septiandch/imumonitor/documents/kontrakkerja_201107.md

# KONTRAK KERJA PENGERJAAN ALAT “INERTIAL MEASUREMENT UNIT (IMU)” UNTUK PENILAIAN ERGONOMI

---
[TOC]
---

## 1.TUJUAN DAN RUANG LINGKUP PEKERJAAN

Alat “Inertial Measurement Unit (IMU)” yang akan dibuat, bertujuan untuk memonitor postur tubuh pekerja atau operator untuk penilaian ergonomi secara real-time yang dapat diaplikasikan di perindustrian.

Terdiri dari 7 buah sensor yang diletakkan di bagian tubuh yang telah ditentukan. Sehingga ppenilaian ergonomi dapat dilakukan dengan mendeteksi sudut tiap bagian tubuh. Jika postur tubuh dianggap membahayakan kesehatan, maka akan ada notifikasi alarm yang akan berbunyi. 

Nilai sudut tiap sensor tersebut juga disimpan ke dalam log dan dapat diupload ke dalam database online dengan menggunakan aplikasi smartphone.

## 2.DESAIN KONSEP

### 2.1 Konsep Sistem
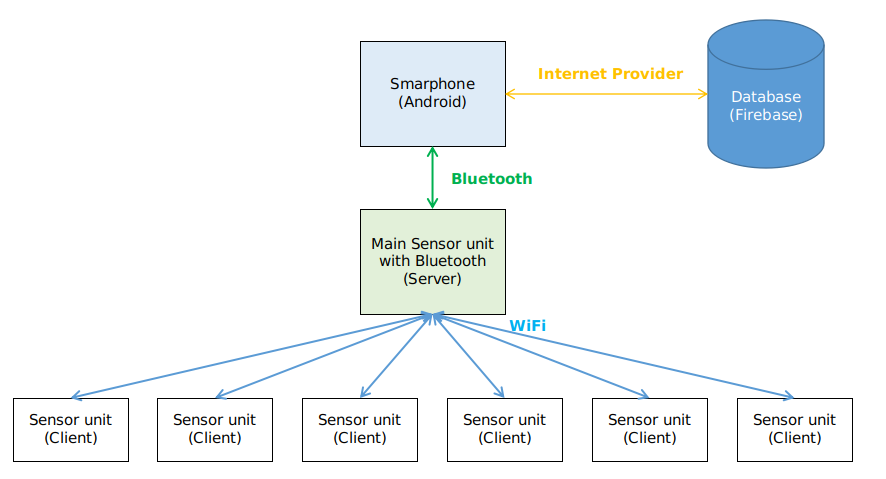
[picture p1: documents/assets/concept.png]
concept


### 2.2 Konsep Alat
Terdiri dari 7 unit modul sensor dengan konfigurasi tiap unit sebagai berikut :				

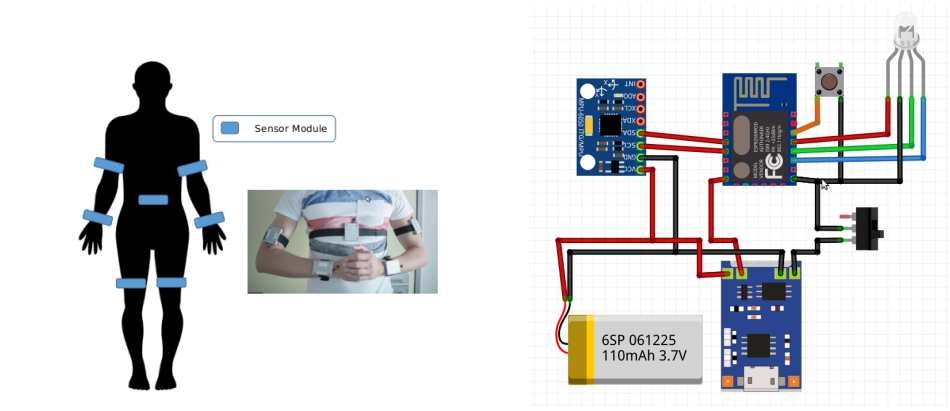
[picture p2: documents/assets/design_idea.png]
design_idea


## 3.ESTIMASI WAKTU PENGERJAAN

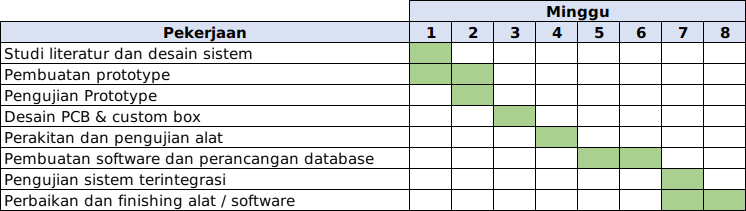
[picture p3: documents/assets/schedule_plan.png]
schedule_plan


*) Pekerjaan dimulai terhitung setelah pembayaran tahap pertama (point [5])

## 4. BATASAN PEKERJAAN

### 4.1 Batasan sistem
Sistem alat yang dikerjakan hanya akan mencakup sesuai dengan desain konsep yang telah dibuat di poin [2]. Jika ada fiitur tambahan atau revisi dapat merujuk ke poin [4.2].

Software yang akan dibuat berupa aplikasi sederhana untuk smartphone android (tidak tersedia untuk Iphone). Dimana aplikasi berfungsi hanya untuk input data pekerja/operator (nama, umur, berat badan, dsb), menerima data log sensor, dan upload data log sensor ke database.

### 4.2 Revisi
Maksimal pengajuan revisi minor adalah sampai sebelum tahap Perbaikan dan finishing alat / software (Minggu ke-6). Untuk revisi major seperti perubahan sistem yang mempengaruhi estimasi waktu pengerjaan, maka perlu di diskusikan lebih lanjut dan akan diperlakukan sebagai pekerjaan terpisah dengan fee dan estimasi tersendiri.

## 5. PEMBAYARAN
Total biaya pembuatan alat “Inertial Measurement Unit (IMU)” adalah sebesar :
Rp. 6.420.000,- dengan detail sebagai berikut :

| Item | Jumlah | Harga/Unit | Harga Total |
| --- | --- | --- | --- |
| Module WiFi + Bluetooth | 1 | 180.000 | 180.000 |
| Module WiFi | 6 | 45.000 | 270.000 |
| Sensor MPU6050 | 7 | 20.000 | 140.000 |
| Alarm Unit | 1 | 5.000 | 5.000 |
| Baterai LiPo | 7 | 150.000 | 1.050.000 |
| Printed Circuit Board (PCB) | 7 | 25.000 | 175.000 |
| Custom 3D Printed Box | 8 | 75.000 | 600.000 |
| Jasa Pembuatan Aplikasi Android | 1 | - | - |
| Jasa Pengerjaan Alat | 1 | 4.000.000  | 4.000.000 |
| TOTAL BIAYA | | | **6.420.000** |

Pembayaran dilakukan secara bertahap dengan ketentuan sebagai berikut:

1. Pembayaran pertama sebesar 25% (dua puluh lima persen) dari nilai total biaya, sejumlah Rp 1.605.000,-. Dibayarkan pada saat kontrak kerja disetujui.

2. Pembayaran kedua sebesar 25% (dua puluh lima persen) dari nilai total biaya, sejumlah Rp 1.605.000,-. Dibayarkan pada saat Perakitan dan Pengujian alat selesai. Di tahap ini, pengerjaan alat sudah mencapai 50% (jika sesuai estimasi, di minggu ke-5).

3. Pembayaran ketiga sebesar 50% (lima puluh persen) dari nilai total biaya, sejumlah Rp 3.210.000,-. Dibayarkan setelah pekerjaan telah selesai. Di tahap ini, alat (hardware + software) akan diserahkan kepada Client.

Pembayaran oleh pihak Client dapat dilakukan dengan cara transfer ke : 

> Bank BCA a/n	: *SEPTIAN DWI CHANDRA*
> No. Rekening	: *7880740398*

**) Mohon melakukan konfirmasi setelah pembayaran*
