septiandch/imumonitor/documents/assets/OWAS_Judgement_Concept.xlsx

Back
OWAS | Condition | Flexion (Roll) | Lateral (Pitch) | Axial (Yaw) | Remark | Input
1 | straight | 0 ~ | x | 0 ~ | Only use Roll & Yaw | Bent Range 0>
2 | bent | ±20 ~ | x | 0 ~
3 | Twisted | 0 ~ | x | ±20 ~ |  | Twisted Range 0>
4 | Bent & Twisted | ±20 ~ | x | ±20 ~
Arms
OWAS | Condition | Upper Arm 1 | Upper Arm 2 | Remark | Input
1 | Below Both arms below shoulder level | 0 ~ | 0 ~ | Only use Roll & Pitch | Shoulder Level range <90>
2 | One arm at or above shoulder level | +90 > | 0 ~
3 | Two arms at or above shoulder level | +90 > | -90 >
Legs
OWAS | Condition | Upper Leg 1 | Lower Leg 1 | Upper Leg 2 | Lower Leg 2 | Remark | Input
1 | Sit | +90 ~ | x | -90 ~ | x | Only use Roll | Sit | Upper Leg <90>
2 | Standing two legs straight | 0 ~ | 0 ~ | 0 ~ | 0 ~ |  | Standing | Upper Leg <0>
3 | Standing one leg straight | 0 ~ | 0 ~ | ±20 ~ | x |  | Standing | Lower Leg <0>
4 | Squatting two legs bent | +20 ~ | +20 ~ | -20 ~ | -20 ~ |  | Squatting | Upper leg <120>
5 | Squatting one leg bent | +20 ~ | +20 ~ | -45 ~ | x |  | Kneeling | Lower legs <90>
6 | Kneeling | +45 ~ | +90 ~ | +45 ~ | -90 ~ |  | Walking | upper Leg <20>
7 | Walking | +45 ~ | x | +45 ~ | x
