septiandch/imumonitor/program/mobileapp/assets/img/save.png

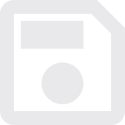
program/mobileapp/assets/img/save.png
