septiandch/imumonitor/hardware/enclosure/enclosure_cover.FCStd

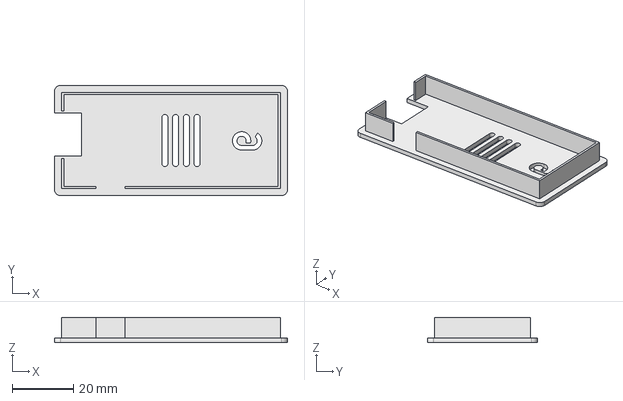
[picture p6: CAD file, 2021-11-16]
hardware/enclosure/enclosure_cover.FCStd
76.0 x 36.0 x 8.25 mm
