septiandch/imumonitor/hardware/enclosure/enclosure_holder_alarm.FCStd

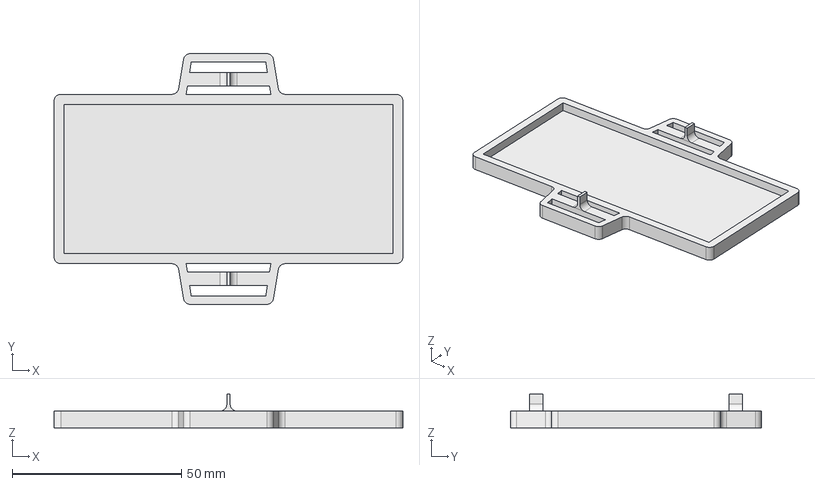
[picture p7: CAD file, 2021-11-16]
hardware/enclosure/enclosure_holder_alarm.FCStd
103.0 x 74.0 x 10.0 mm
