septiandch/imumonitor/hardware/enclosure/enclosure_server.FCStd

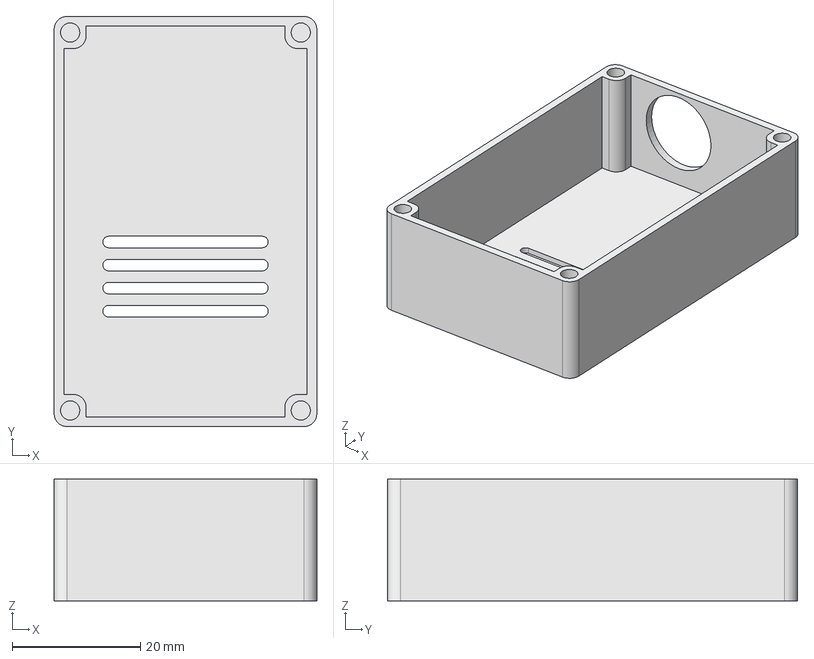
[picture p8: CAD file, 2021-04-25]
hardware/enclosure/enclosure_server.FCStd
41.0 x 64.0 x 19.0 mm
