septiandch/imumonitor/hardware/enclosure/enclosure_container.FCStd

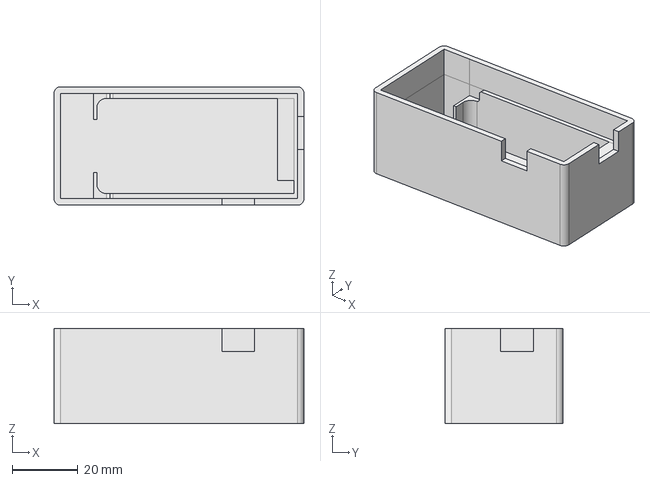
[picture p9: CAD file, 2021-03-23]
hardware/enclosure/enclosure_container.FCStd
76.0 x 36.0 x 29.0 mm
