septiandch/imumonitor/hardware/enclosure/enclosure_holder.FCStd

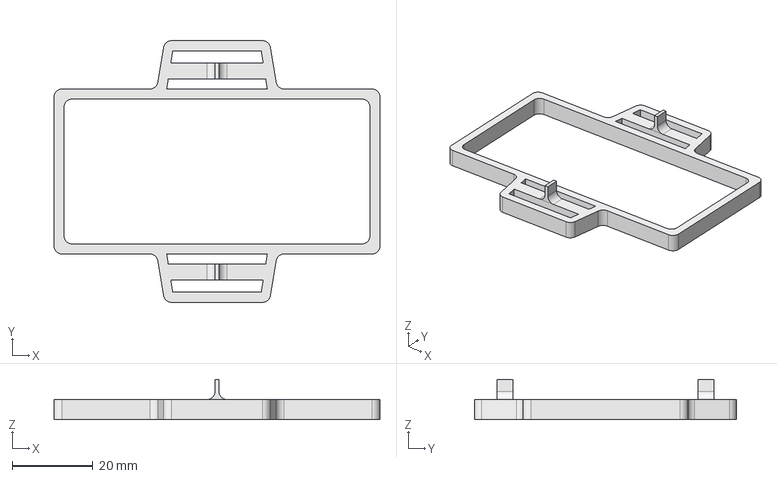
[picture p10: CAD file, 2021-03-23]
hardware/enclosure/enclosure_holder.FCStd
81.0 x 65.0 x 10.0 mm
