septiandch/imumonitor/hardware/schematics/imunodes/Output/imunodes-brd.pdf

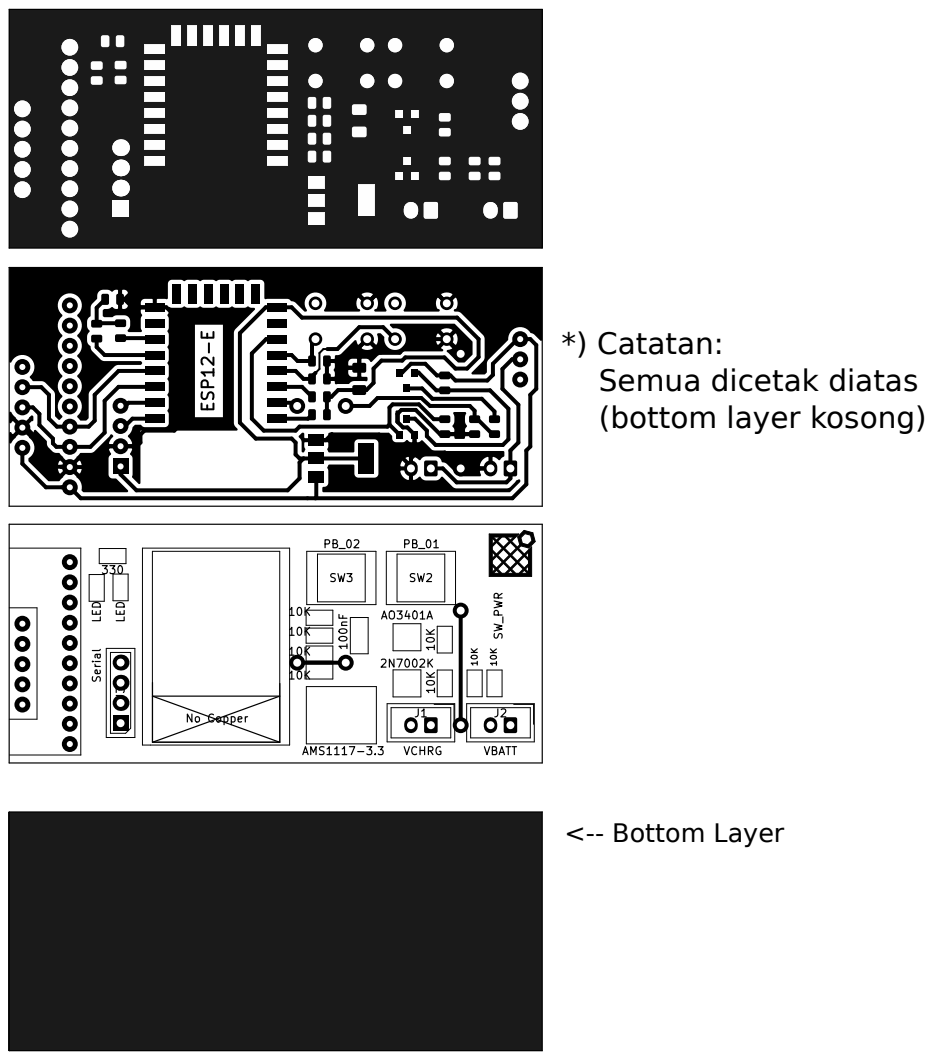
[picture p11: page 1]
<-- Bottom Layer

*) Catatan:
Semua dicetak diatas
(bottom layer kosong)
