septiandch/imumonitor/hardware/schematics/imunodes/imunodes.kicad_pcb

## KiCad design hardware/schematics/imunodes/imunodes.kicad_pcb (2021-01-02)

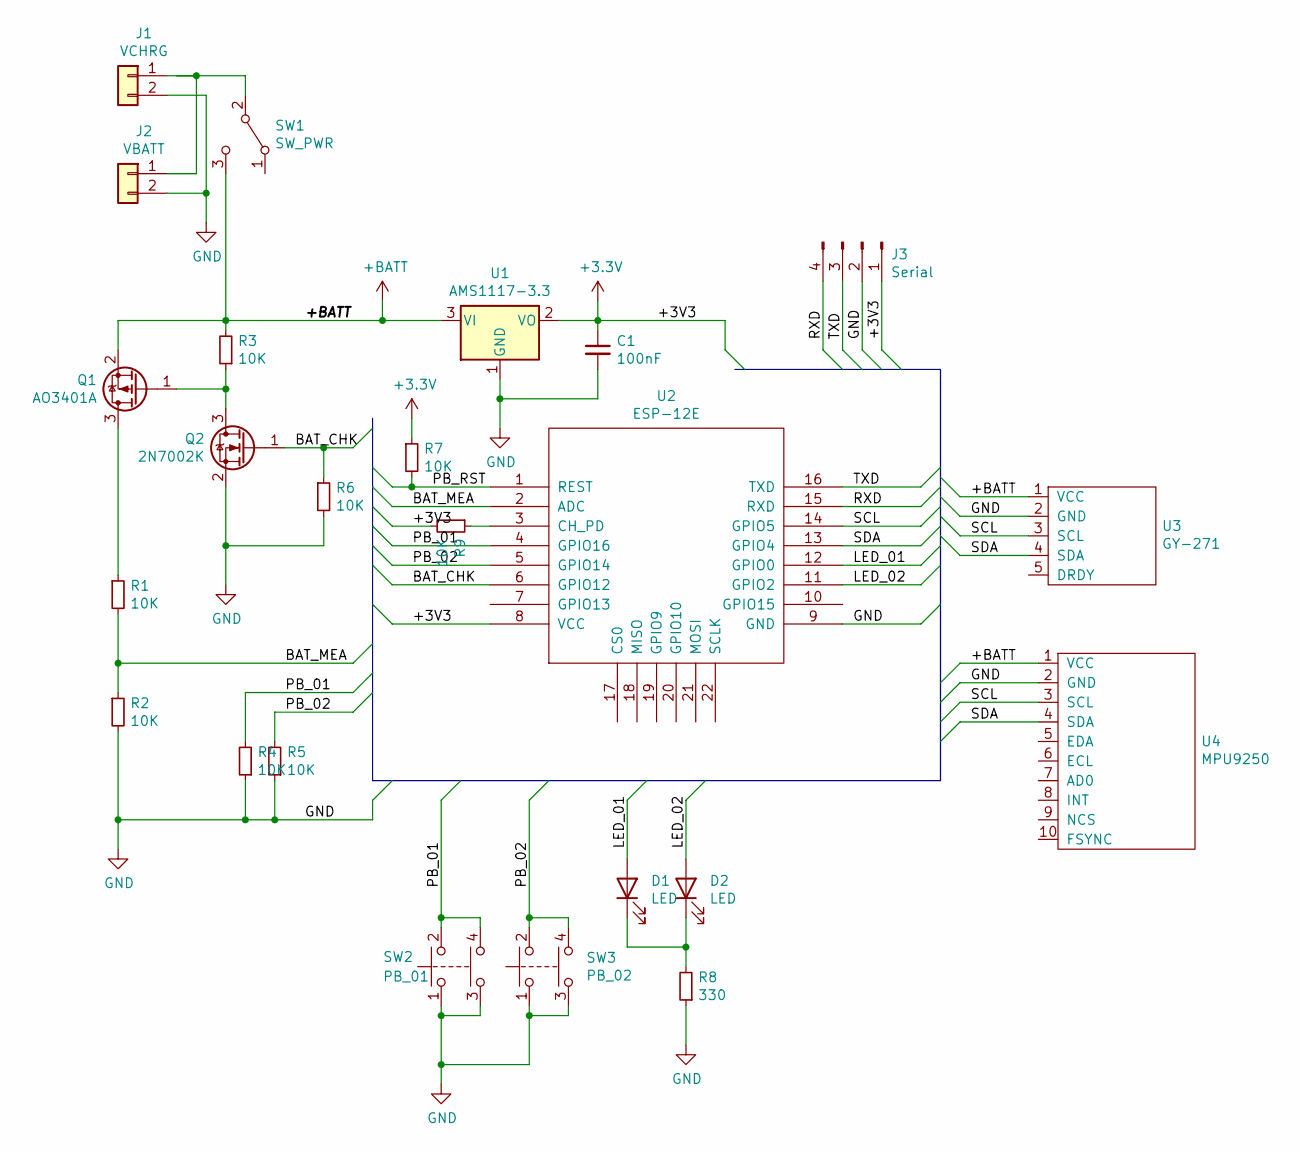
[picture p12: schematic imunodes.sch]

Parts:
C1: 100nF; C_1206_3216Metric
D1, D2: LED; LED_0805_2012Metric
J1: VCHRG; JST_EH_B2B-EH-A_1x02_P2.50mm_Vertical
J2: VBATT; JST_EH_B2B-EH-A_1x02_P2.50mm_Vertical
J3: Serial; PinHeader_1x04_P2.54mm_Vertical
Q1: AO3401A; SOT-23
Q2: 2N7002K; SOT-23
R1, R2, R3, R4, R5, R6, R7, R9: 10K; R_0805_2012Metric
R8: 330; R_0805_2012Metric
SW1: SW_PWR; SlideSwitch_SS12D00_1P2T_H3mm
SW2: PB_01; SW_TH_Tactile_Omron_B3F-10xx
SW3: PB_02; SW_TH_Tactile_Omron_B3F-10xx
U1: AMS1117-3.3; SOT-223-3_TabPin2
U2: ESP-12E; ESP-12E_SMD
U3: GY-271; GY271
U4: MPU9250

Connections:
+3V3: C1.1, J3.1, R7.1, R9.2, U1.2 (VO), U2.8 (VCC)
+BATT: Q1.2 (S), R3.2, SW1.3 (C), U1.3 (VI), U3.1 (VCC), U4.1 (VCC)
/BAT_CHK: Q2.1 (G), R6.1, U2.6 (GPIO12)
/BAT_MEA: R1.2, R2.1, U2.2 (ADC)
/LED_01: D1.2 (A), U2.12 (GPIO0)
/LED_02: D2.2 (A), U2.11 (GPIO2)
/PB_01: R4.2, SW2.2, SW2.4, U2.4 (GPIO16)
/PB_02: R5.2, SW3.2, SW3.4, U2.5 (GPIO14)
/PB_RST: R7.2, U2.1 (REST)
/RXD: J3.4, U2.15 (RXD)
/SCL: U2.14 (GPIO5), U3.3 (SCL), U4.3 (SCL)
/SDA: U2.13 (GPIO4), U3.4 (SDA), U4.4 (SDA)
/TXD: J3.3, U2.16 (TXD)
GND: C1.2, J1.2, J2.2, J3.2, Q2.2 (S), R2.2, R4.1, R5.1, R6.2, R8.1, SW2.1, SW2.3, SW3.1, SW3.3, U1.1 (GND), U2.9 (GND), U3.2 (GND), U4.2 (GND)
unnamed: D1.1 (K), D2.1 (K), R8.2
unnamed: J1.1, J2.1, SW1.2 (B)
unnamed: Q1.1 (G), Q2.3 (D), R3.1
unnamed: Q1.3 (D), R1.1
unnamed: R9.1, U2.3 (CH_PD)

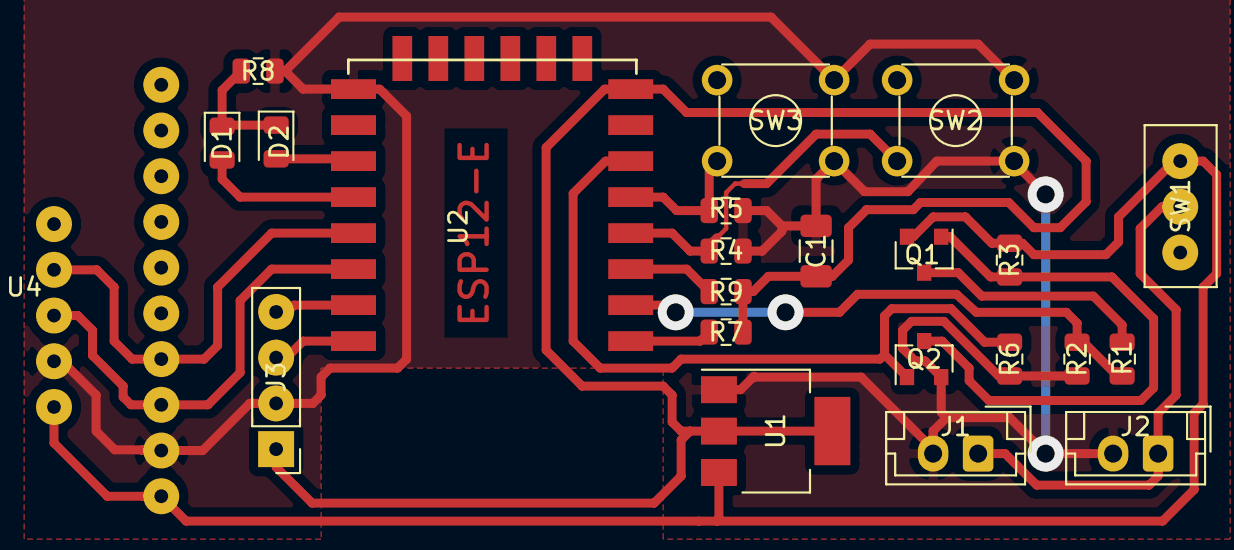
[picture p13: board imunodes.kicad_pcb from above]

Board: 2 copper layers, 24 parts (0 on the bottom side), 19 nets.
