septiandch/imumonitor/(commit log)

2021-01-02 20210102_First Commit
    [imunodes.kicad_pcb, imunodes.sch]
2021-01-24 **[ New ]** - Sensor Monitor view - Bottom Sheet view
    **[ Fixes ]**
    - Received Value conversion bug fix
    - Linechart view improvement
    - Dummy registration fix
    - Sensor Monitor initial dummy value fix
2021-01-27 [New] - Shared Prefferences - Horizontal Number Picker for setting values - User Data Updates - OWAS data base
    [Fixed]
    - Received values conversion fix
    - BLE Device Screen return without selected device bug fix
2021-03-23 Add Freecad Enclosure Drawing
    [enclosure_container.FCStd, enclosure_cover.FCStd, enclosure_holder.FCStd]
2021-04-14 New Structure: Separate as ImuNodes and ImuServer
    [OWAS_Judgement_Concept.xlsx]
2021-04-25 ImuNodes & ImuServer Fixes
    GET request improvement so no node data can be retrieved sequentially
    [definitions.h, main.cpp, prototypes.h, webserver.cpp, wifi.cpp]
2021-04-25 ImuServer Case
    Cover to attach the device to Battery case
    [enclosure_server.FCStd]
2021-04-25 Multiple Data Submission
    Show table for sensor log
2021-06-19 WebServer now shown as JSON format
    Using ArduinoJson library
2021-07-10 ESP32 Support
    Change ESP32 as sensor node and alarm function
2021-11-16 It works !
    - Desktop App Added
    - ImuServer deletion (all working as node, use dedicated access point)
    [OWAS_Judgement_Concept.xlsx, Tabel Level Setting.xlsx, enclosure_container.FCStd, enclosure_cover.FCStd, enclosure_holder.FCStd, enclosure_holder_alarm.FCStd, enclosure_server.FCStd, imunodes.kicad_pcb]
2021-11-16 MPU6500 MPU9250 Switch Fixes
    [main.cpp, prototypes.h, sensors.cpp, webserver.cpp]
2021-11-27 Date Label fix, Legs OWAS Change (still in progress)
2021-11-30 Leg OWAS Judgement Update
2021-12-05 Leg OWAS Judgement update & tested
